vkdati/genome-sketch-rtl-to-gds/(commit log)

2026-10-22 feat(golden-model): implement SCL 180nm Genome Sketching ASIC (ntHash-32 + Banked HLL) golden model, datasets, and RTL test vectors
2026-11-09 Phase C: Complete 180nm RTL-to-GDSII physical design, 4-metal routing, SPEF STA/power signoff, and GDSII layout
